LangFlo00/Projekt-RETI-Ladesaeule/Datenblätter/Einpoliger_Schaltplan.pptx

Ladesäule R-Bau L3E

3

Zuleitung HV

X0:1,2,3,N,PE

UMG604 I1-I3

40A/30mA
B

60A/5A

RCD

3

F100

F200

RCD

40A/30mA
B

F300

RCD

40A/30mA
A

UMG604 U1-U3

F1

B32

F2

B32

Z2

Z3

B13

SDM360

F4

Z1

SDM720

SDM720

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
-RPI
-EVSE

UMG604

Q1

EVSE

rel

A1

Q2

EVSE

rel

A1

X1:1,2,3,N,PE
CP,PP

X2:1,2,3,N,PE
CP,PP

K1

A2

K2

A2
