LangFlo00/Projekt-RETI-Ladesaeule/Projektvernissage/Projektvernissage_LaMa2_Pitch.pptx

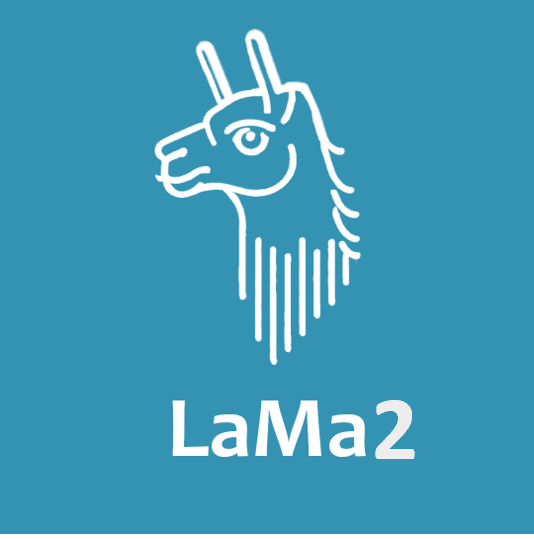
[picture p27: figure]

Projekt LadeManagement 2

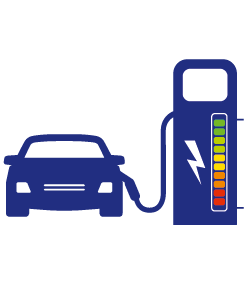
[picture p28: figure]
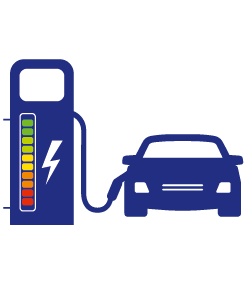
[picture p29: figure]
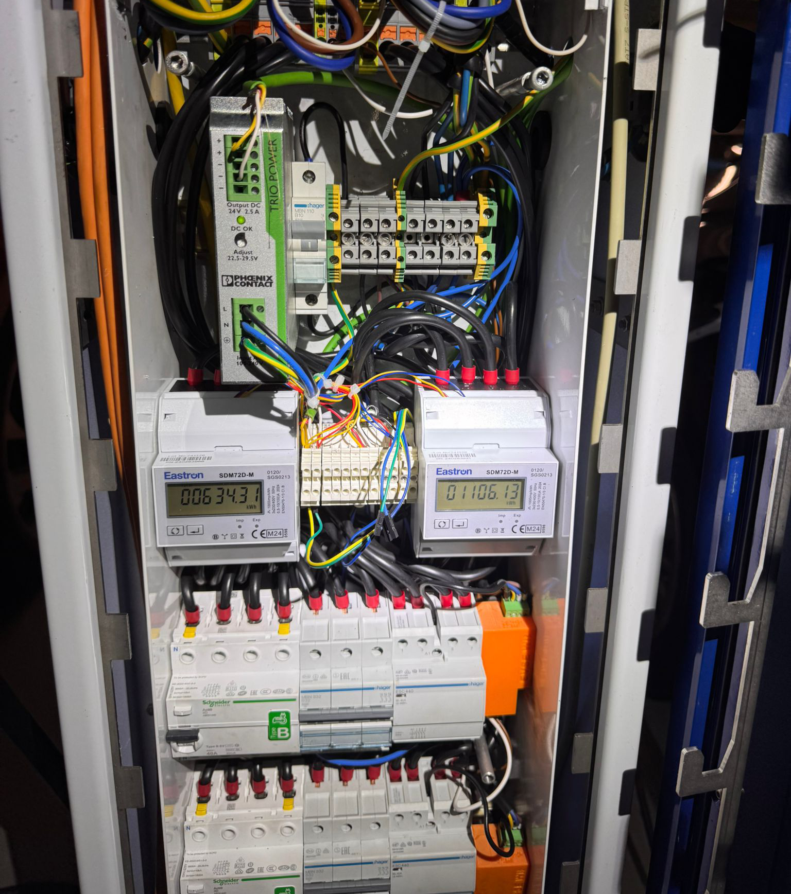
[picture p30: figure]
Hängebrücke über dem Wasser bei Sonnenuntergang

Was machen wir besser?
- Authentifizierung über Kartenleser mit den HM-Karten
- Optimierter Algorithmus für das Laden von mehreren E-Autos
- Anbinden von zusätzlichen Messgeräten
- Benachrichtigung wenn Auto vollständig geladen
