LangFlo00/Projekt-RETI-Ladesaeule/alte Dokus/LAMA-Doku/lama-doku-main/Sprint1.pptx

## Projekt Lademanagement

- Fuchs Joshua, Schulz Lukas, Häusler Alex

14.11.24

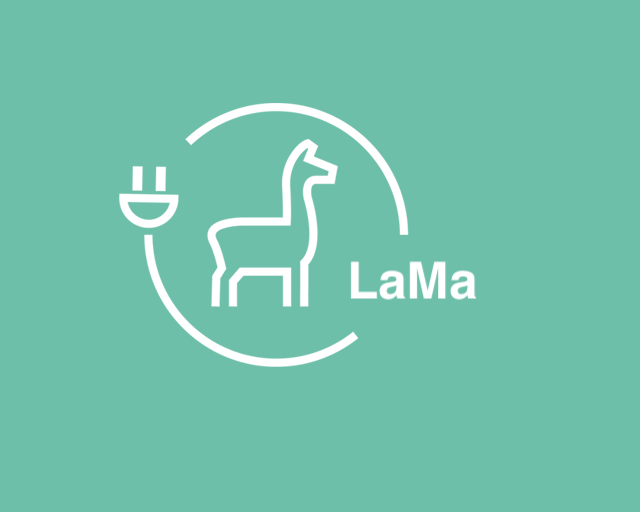
[picture p31: figure]
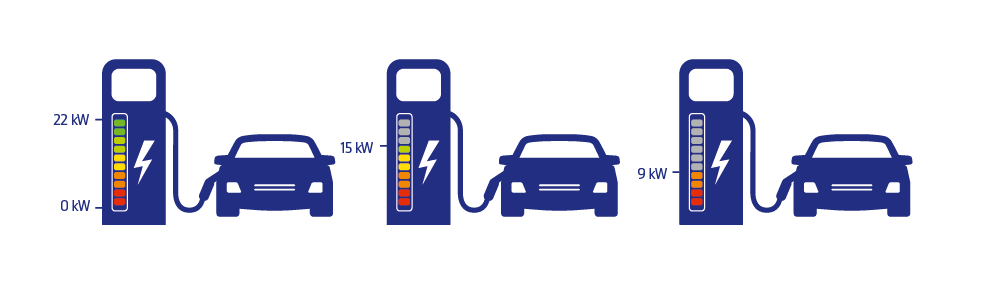
[picture p32: figure]

## Agenda-LAMA

1. Einführung in das Projekt und Zielsetzung
2. Simulationserläuterung und -präsentation
3. Übergabe an den Testaufbau
4. Demonstration der Datenkommunikation
5. Abschluss und Zusammenfassung

## 1. Einführung Projekt und Zielsetzung

Hängebrücke über dem Wasser bei Sonnenuntergang

Aktuell :
- Kein aktives Lademanagement
- Kein Datenabruf von Außen
Zielsetzung:
- Laderegler regelt aktiv für effizientes Laden
- Live-Daten Abruf und Fernsteuerung über Solarlabor

## Simulation

- Fuchs Joshua, Schulz Lukas, Häusler Alex

## Slide 5

Szenario 1 (keine Schuko-Last):
Szenario 2 (10A Schuko-Last auf Phase 1):

Auto 1 wird angehängt

3-phasig

3-phasig


Auto 2 wird angehängt

3-phasig

32A

16A

16A

Auto 1 wird angehängt

Auto 2 wird angehängt -> 2x 16A

3-phasig

3-phasig

1-phasig auf Phase 2

16A

32A

16A

## Slide 6

Szenario 3 (10A Schuko-Last auf Phase 1):

Auto 1 wird angehängt

1-phasig auf Phase 2

1-phasig auf Phase 2

Auto 2 wird angehängt

1-phasig auf Phase 1

32A

32A

16A

## 3. Übergabe an den Testaufbau

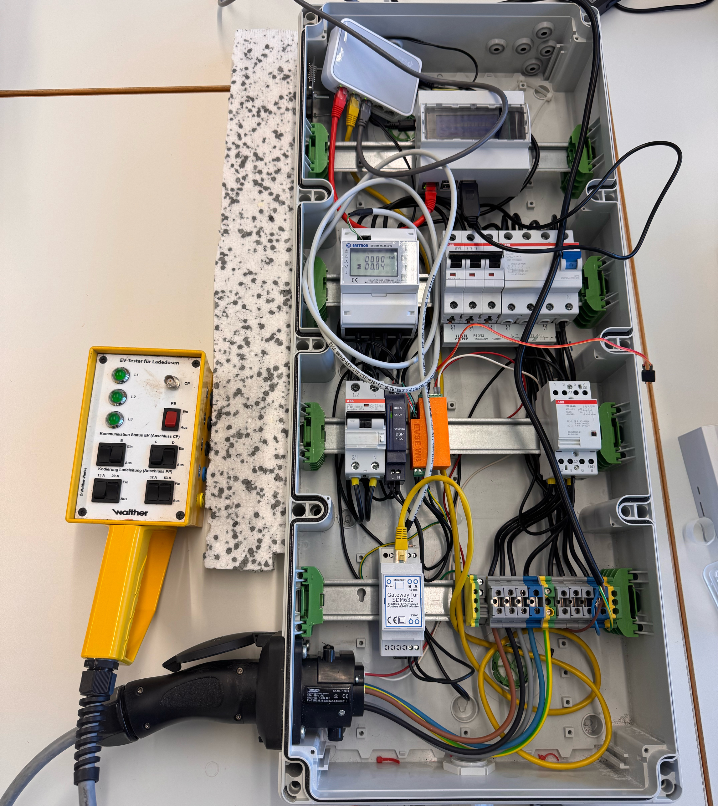
[picture p33: figure]
Hängebrücke über dem Wasser bei Sonnenuntergang

Raspberry Pi

Eastron Stromzähler

EVSE Laderegler

Schütz, schaltet nach EVSE
Kommunikation den
Strom frei für Typ 2

EV Tester für Typ 2

## 4. Demonstration der Datenkommunikation

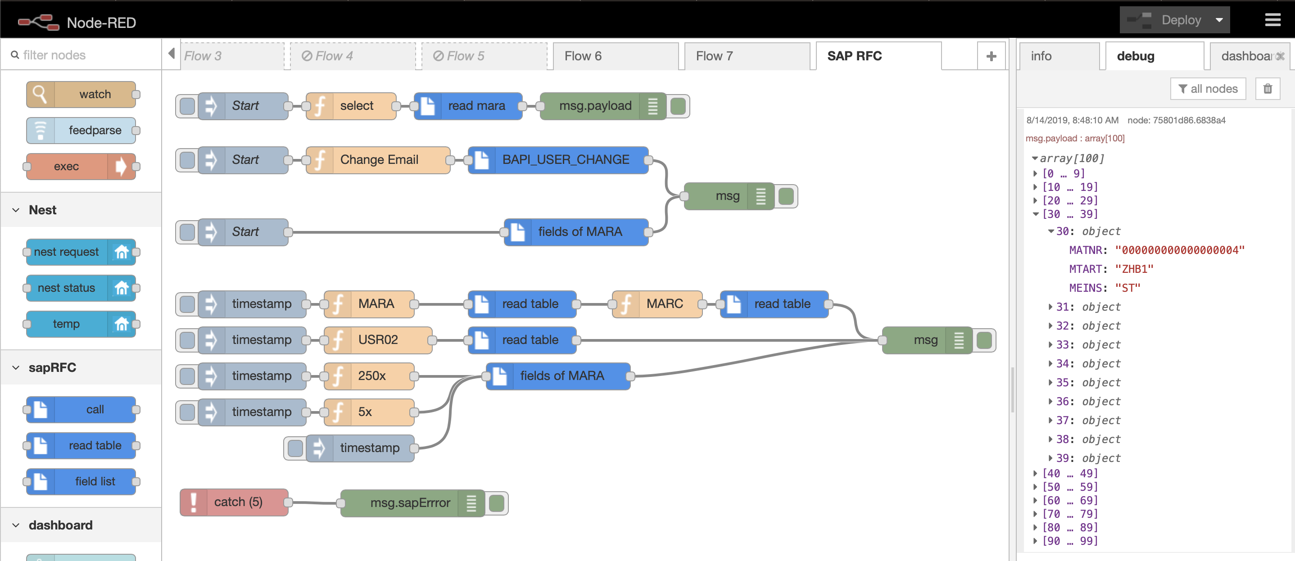
[picture p34: figure]
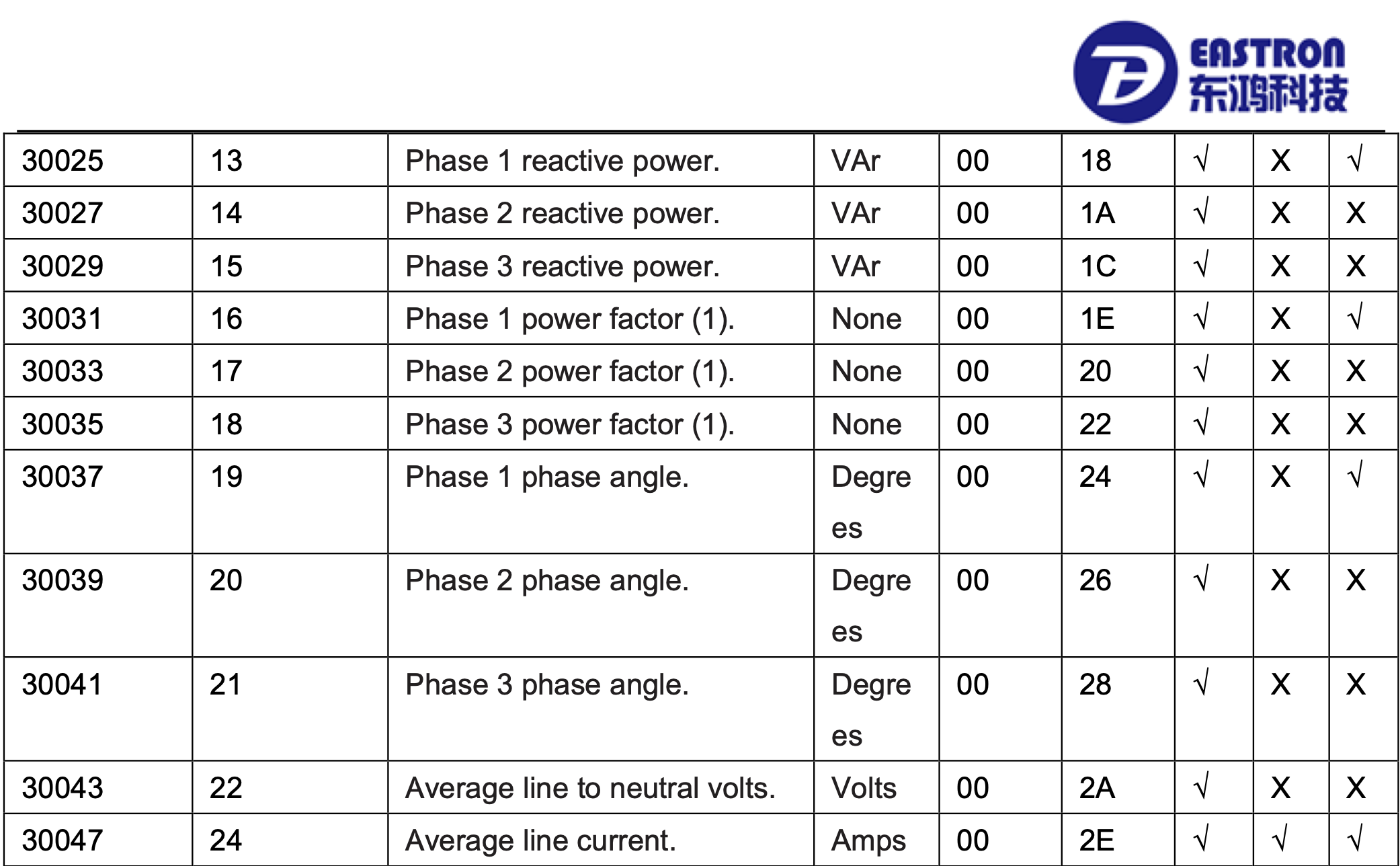
[picture p35: figure]

## 5. Abschluss und Zusammenfassung

Was Aktuell funktioniert:
- Der Raspberry Pi kann über Modbus mit dem Laderegler kommunizieren
- Node Red erkennt den Fahrzeugstatus (Verbunden, Lädt, Idee…)
Aufkommenden Ziele des Projektes:
- Messgeräte (Janitza und Eastron) über den Raspi auslesen über Node Red und Daten Verarbeiten
- Lade-Algorithmus erproben an beide Anschlüssen mit Testanschlüssen von bspw. Glühbirne / Heizlüfter
- Übertragen der Funktionalität auf Ladesäule in TG
- Datenempfang über Solarlabor implementieren, erproben
