LangFlo00/Projekt-RETI-Ladesaeule/Projektvernissage/Pitch_Folie.pptx

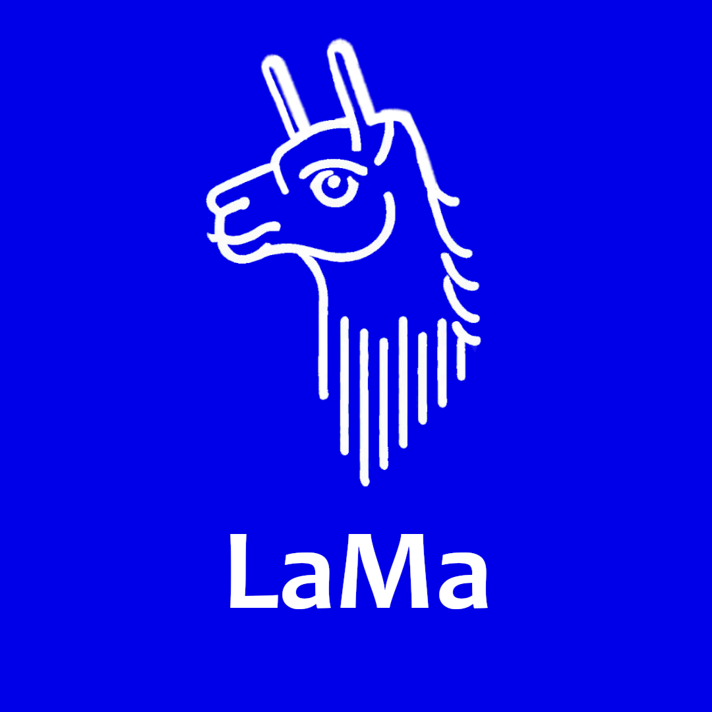
[picture p50: figure]

Projekt Lademanagement

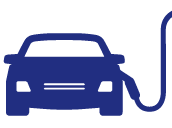
[picture p51: figure]
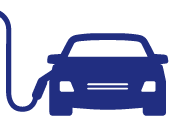
[picture p52: figure]

35 A Sicherung

Lösung: LaMa-Ladealgorithmus,
- Stromfluss dynamisch für die Autos einstellt & überwacht
- Sichert vor Überlast
- Reduziert Ladezeiten
