LangFlo00/Projekt-RETI-Ladesaeule/Sonstiges/Sprint/Sprint1.pptx

## LaMa

Toni Winkler, Florian Langlechner, Benedikt Schwendner, Anne Reddig Wiegand

## Slide 2

Agenda
1. Rückblick
2. Ladeoptimierung
3. Kartenleser TWN4 Multitech
4. Steuer-/Ladestromkreis
5. Benutzeranlegung und Freischalten
6. Sprint-Flow
7. Ausblick

## Slide 3

1. Rückblick

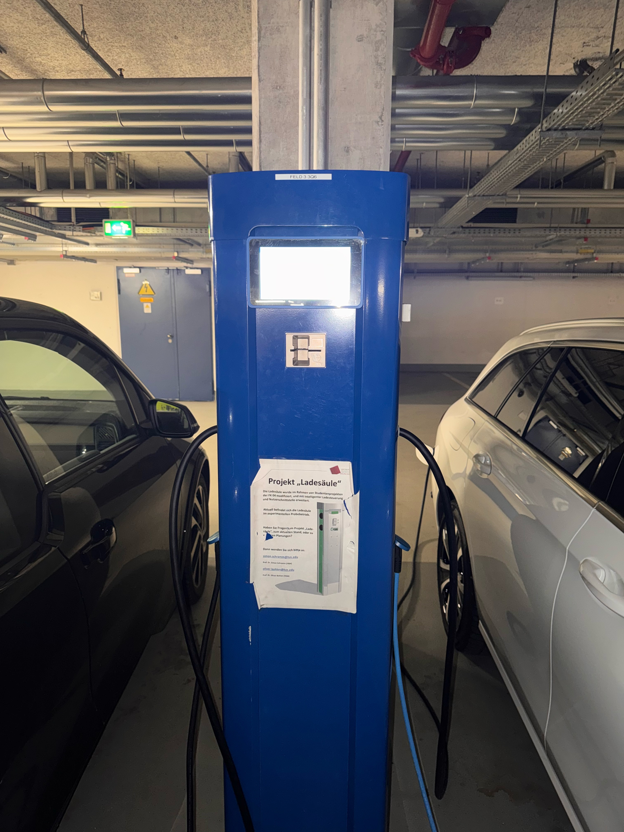
[picture p53: figure]

- Ladesäule gebaut von vorangegangenem Semester
- Ladesäule funktioniert
- hat kein Lademanagment
- wertet die Ladedaten nicht aus

## Slide 4

2. Ladeoptimierung

Stromzähler für CCS2 Stecker

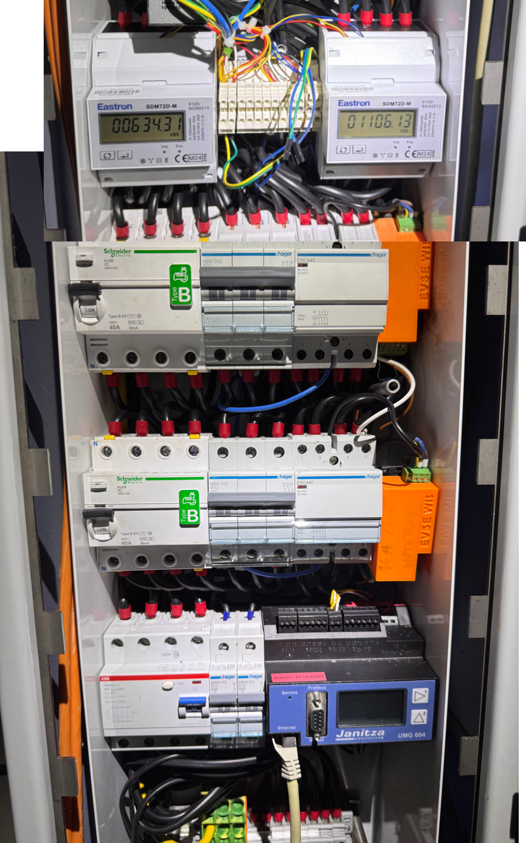
[picture p54: figure]

Ziel:
Eine Ladeoptimierung entwickeln
Vorgehen:
1. Durch die Stromzähler die Belastung der einzelnen Ladedosen messen
2. Entsprechend der angeschlossenen Fahrzeuge die Ladeleistung einstellen
(Durch Priorisierung und Trenddaten)

Stromzähler für gesamte Ladesäule

## 3. Kartenleser TWN4 Multitech

- Kommunikation über USB
- Verschiedene Möglichkeiten
  - HID: Konfiguration als Keyboard -> Schwierigkeiten in Node-Red
  - CDC: serielle Kommunikation

## Konfiguration in Node-Red

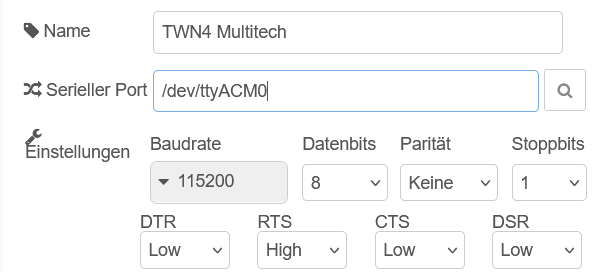
[picture p55: figure]

## 4. Steuer-/Ladestromkreis

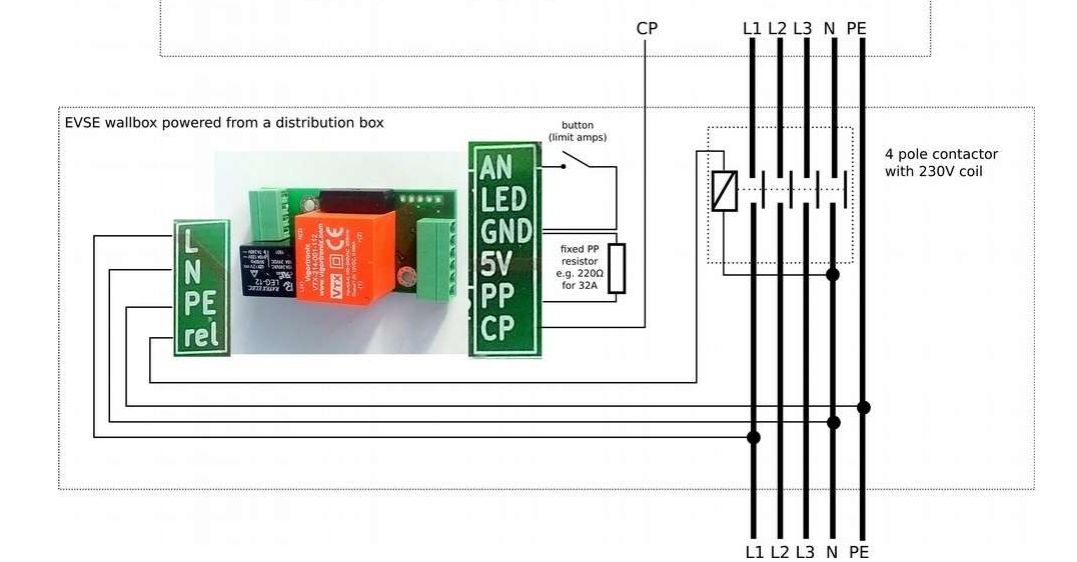
[picture p56: figure]
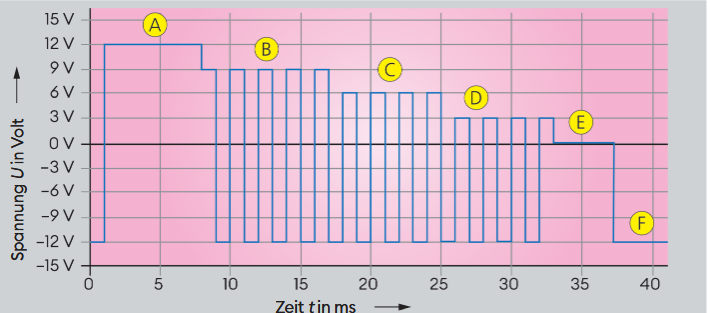
[picture p57: figure]

## Slide 8

5. Benutzeranlegung und Freischalten

Ziele:
Ladevorgang freischalten, Trenddaten erfassen und zuordnen

Personalisiertes Laden
→ Erfassen der Benutzer durch Kartenlesegerät

Speichern der Benutzer in einer Datenbank

Erfassen von den typischen Ladezeiten der einzelnen Benutzer

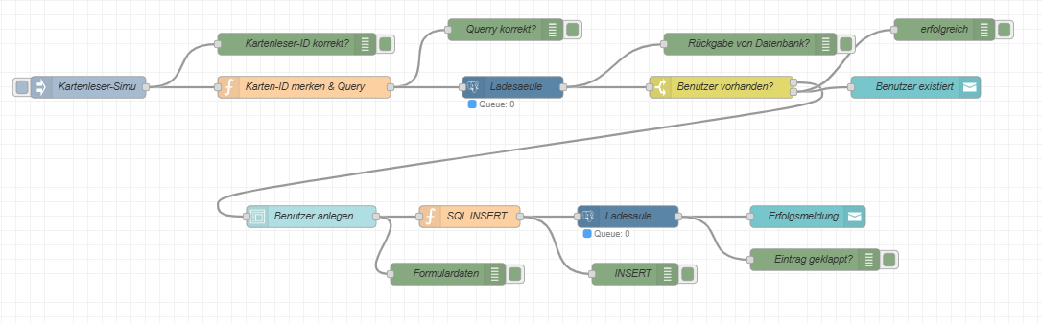
[picture p58: figure]

## 6. Sprint-Flow

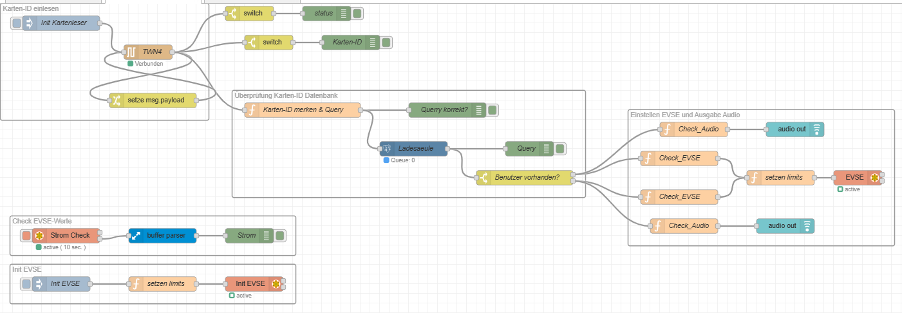
[picture p59: figure]
A diagram of a diagram

## 7. Ausblick

- Konfigurieren der Kartenleser-Firmware, z.B. Beep verändern, Format der ID
- Einbau der Authentifizierung in bestehenden LaMa-Flow
- Automatisch Anlegung von neuen Benutzern in der Datenbank
- Loggen der Ladevorgänge über PostgreSQL
- Stromzählerauswertung in Node-red
- Implementierung des Systems auf dem Raspberry
