LangFlo00/Projekt-RETI-Ladesaeule/Projektvernissage/LaMa2Poster.pdf

# Effizientes LadeManagement

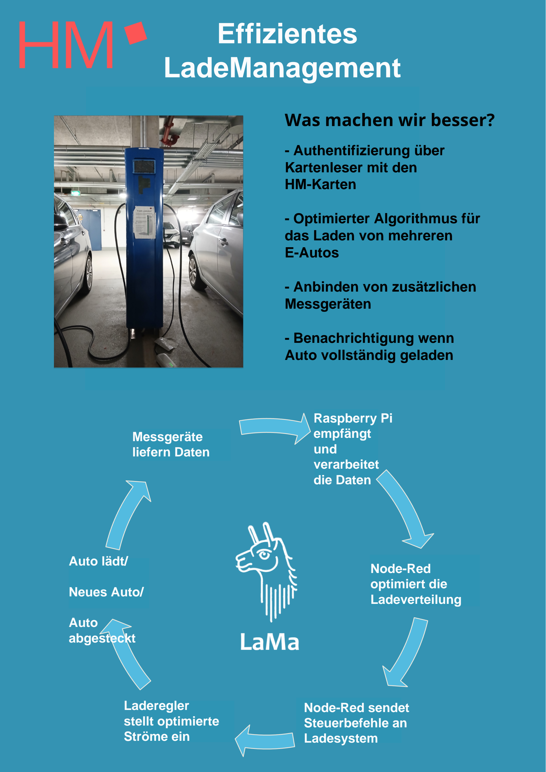
[picture p60: page 1]

### 35 A

Sicherung

Messgeräte
liefern Daten

Auto lädt/

Neues Auto/

Auto
abgesteckt

Laderegler
stellt optimierte
Ströme ein

Node-Red sendet
Steuerbefehle an
Ladesystem

Raspberry Pi
empfängt
und
verarbeitet
die Daten

Node-Red
optimiert die
Ladeverteilung
- Authentifizierung über
Kartenleser mit den
HM-Karten
- Optimierter Algorithmus für das Laden von mehreren
E-Autos
- Anbinden von zusätzlichen Messgeräten
- Benachrichtigung wenn
Auto vollständig geladen
