LangFlo00/Projekt-RETI-Ladesaeule/Projektvernissage/LaMaPoster.pdf

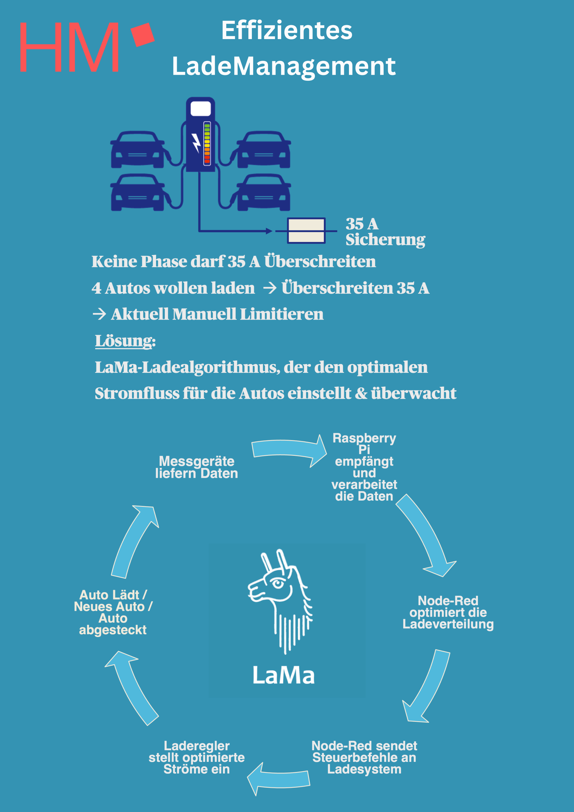
[picture p61: page 1]

Effizientes
LadeManagement
