LangFlo00/Projekt-RETI-Ladesaeule/3D-Druck/Screenshot_20250515-121134_Google.jpg

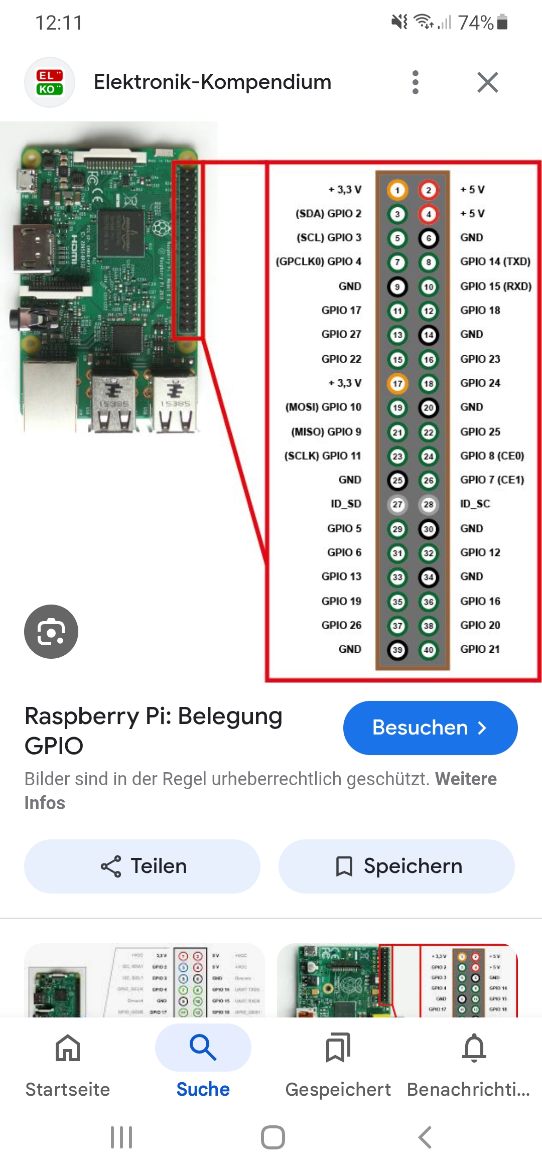
3D-Druck/Screenshot_20250515-121134_Google.jpg
