LangFlo00/Projekt-RETI-Ladesaeule/alte Dokus/LAMA-Doku/entwicklerdoku-main/images/evse_register_2.png

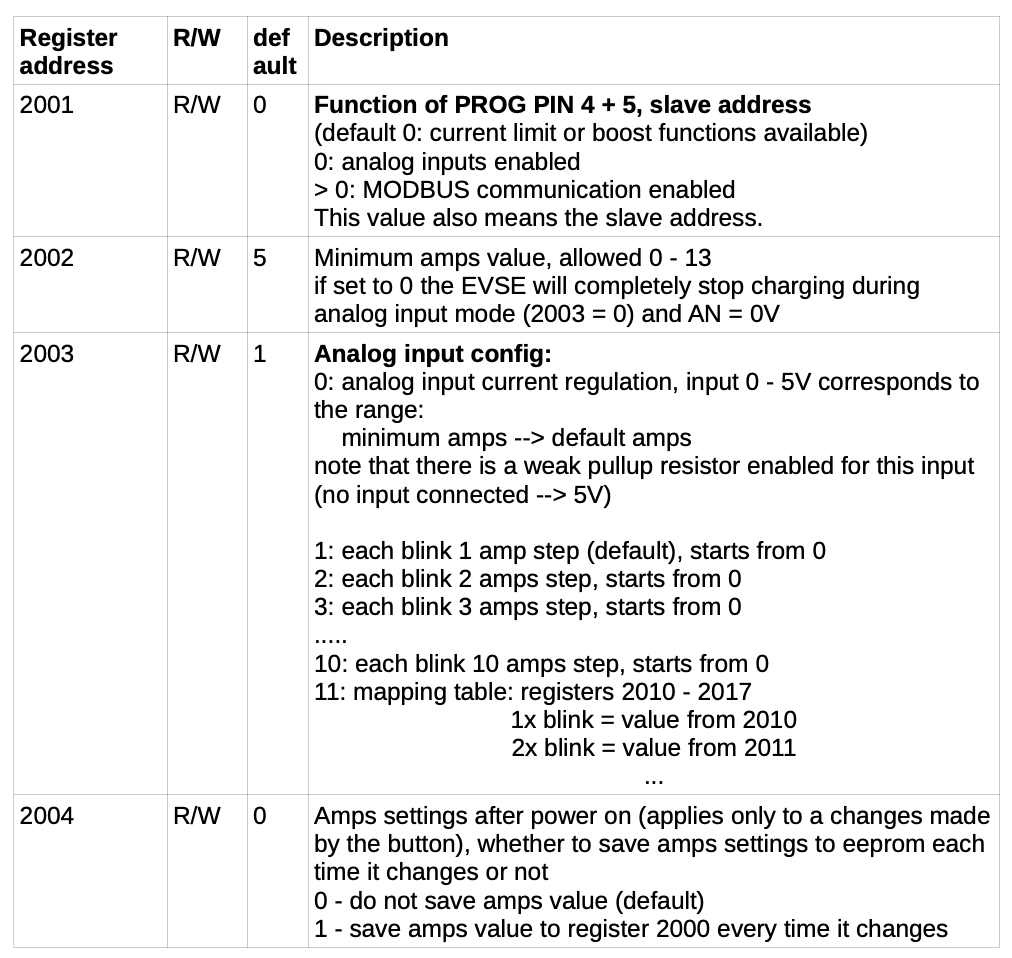
alte Dokus/LAMA-Doku/entwicklerdoku-main/images/evse_register_2.png
