LangFlo00/Projekt-RETI-Ladesaeule/alte Dokus/LAMA-Doku/entwicklerdoku-main/images/init.png

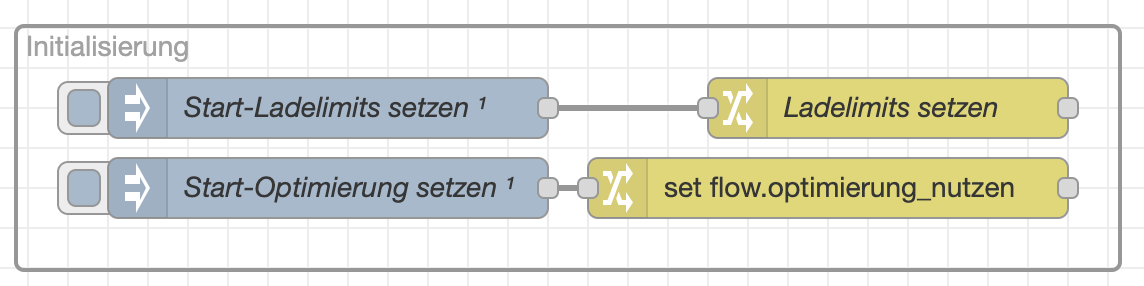
alte Dokus/LAMA-Doku/entwicklerdoku-main/images/init.png
