LangFlo00/Projekt-RETI-Ladesaeule/alte Dokus/LAMA-Doku/entwicklerdoku-main/images/reload_anzeigeseite.png

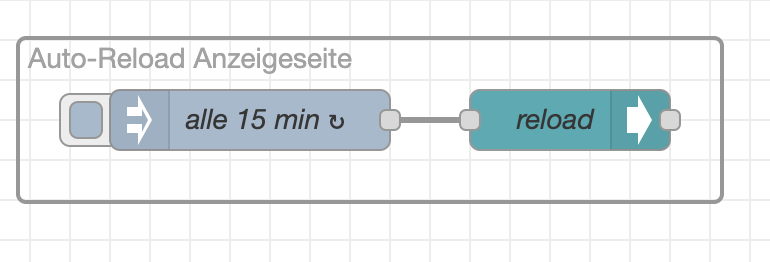
alte Dokus/LAMA-Doku/entwicklerdoku-main/images/reload_anzeigeseite.png
