LangFlo00/Projekt-RETI-Ladesaeule/alte Dokus/Projekt9_Ladesaeule/Projekt9_Ladesaeule/Materialliste.xls

Materialliste Vorprojekt
Lfd. Nr | Artikel | Anzahl | Einzelpreis Netto
1 | Raspberry Pi 3 Model B mit Gehäuse | 1 | 34.90 €
2 | Netzteil 12V MW HDR-30-12 | 1 | 15.35 €
3 | Netzteil 5V MW HDR-15_5 | 1 | 12.49 €
4 | ABB Stotz FI/LS Schalter 6kA DS201A-B16/0,03 | 1 | 27.83 €
5 | ABB Stotz FI-Schutzschalter pro M Compact F204A-40/0,03 | 1 | 26.98 €
6 | ABB Stotz Sicherungsautomat B, 6kA, 32A, 3P S203-B32 | 1 | 22.82 €
7 | ABB Stotz Installationsschütz 4S EBS 24-40 380V AC/DC | 1 | 28.67 €
8 | Mennekes Stecker Star TOP 32A, 5P, 6h, 400V, IP44 | 1 | 5.91 €
9 | PHOENIX C. 1409681 Ladesteckd. Typ 2 | 1 | 98.25 €
10 | PHOENIX C. Schutzdeckel EV-T2SC | 1 | 18.23 €
11 | PHOENIX C. AC-Ladesteuerung 3 Phasen, Mode 3 EM-CP-PP-ETH | 1 | 208.19 €
12 | H07RN-F 5x6mm² (in m) | 5 | 9.25 €
13 | H07V-K 6mm² (in m) | 100 | 29.40 €
14 | Kabelbinder | 10 | 1.00 €
15 | Gehäuse ca. 50x20x80cm | 1 | 110.00 €
16 | Aderendhülsen | 100 | 6.00 €
17 | SD-Karte Raspberry Pi | 1 | 6.95 €
18 | Erweiterungs-Platine Schwarz, Blau sbc-rfid-rc522 1503746-62 | 1 | 8.50 €
19 | Erweiterungs-Platine SBC-RFID-CLIP 1539582-62 | 1 | 4.80 €
Materialliste Erweiterung
 | PHOENIX Contact Verriegelung 1624129 Typ EV-T2M3S E-LOCK 12V | 1 | 44.61 €
 | TP-Link TL-SF1005D Netzwerk Switch (5x10/100MBit/s RJ45ports) | 1 | 8.32 €
Materialliste Emulator
 | Ladedose, Typ | 1 | 75.55 €
 | BIG 800001303 . Bobby - Car - Classic rot | 1 | 27.72 €
 | Drehschalter 250V/AC 5A Schaltpositionen 3 2x45° TRU COMPONENTS | 2 | 6.29 €
 | Meldeleuchte grün 230V BACO L20SC10H | 3 | 5.98 €
 | Hutschiene ungelocht Stahlblech 106mm Fibox Euronord | 1 | 1.27 €
 | Europlatine Hartpapier 90 mm x 50 mm 35 µm Rastermaß 5.08 mm | 1 | 1.15 €
 | verschiedene Widerstände, Lötzinn, Lötstifte | 1 | 0.84 €
 | Kleinstmaterial, Schrauben, Abstände, Scharniere, Flügelmutter | 1 | 7.98 €
