LangFlo00/Projekt-RETI-Ladesaeule/3D-Druck/Bildschirmhalterung/Bilschirm-Rahmen_v4.stl

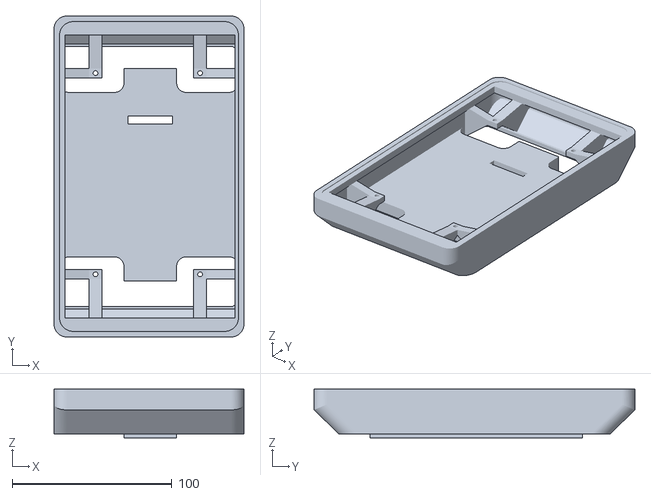
[picture p70: CAD file, 2026-10-05]
3D-Druck/Bildschirmhalterung/Bilschirm-Rahmen_v4.stl
119.0 x 201.0 x 30.5
