LangFlo00/Projekt-RETI-Ladesaeule/3D-Druck/Leserhalter_3D-Druck_v7.3mf

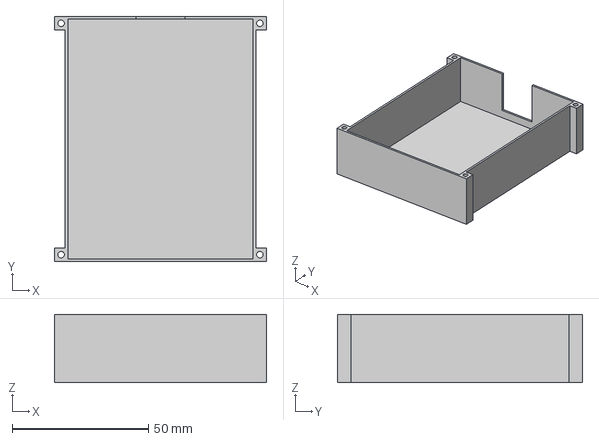
[picture p71: CAD file, 2026-10-05]
3D-Druck/Leserhalter_3D-Druck_v7.3mf
78.0 x 90.0 x 25.0 mm
