LangFlo00/Projekt-RETI-Ladesaeule/3D-Druck/Bildschirmhalterung/Pi-Halterung_v4.stl

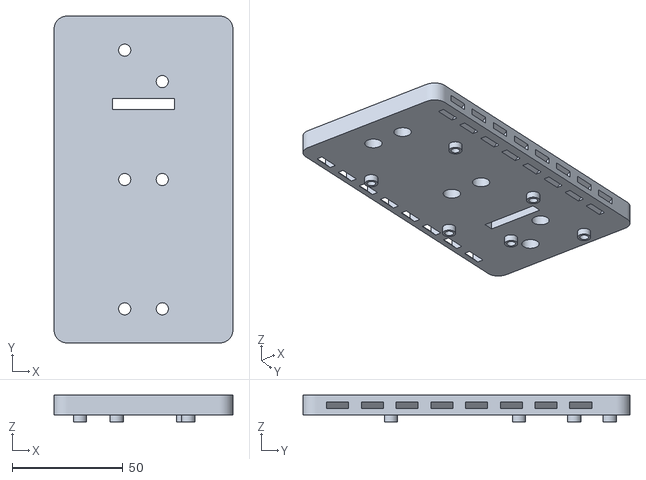
[picture p72: CAD file, 2026-10-05]
3D-Druck/Bildschirmhalterung/Pi-Halterung_v4.stl
81.0 x 147.9 x 12.0
