LangFlo00/Projekt-RETI-Ladesaeule/(list of files, cad)

Other CAD files:
3D-Druck/Bildschirmhalterung/Pi-Halterung.f3d
3D-Druck/Leserhalter v7.f3d
alte Dokus/LAMA-Doku/lama-doku-main/Bildschirmhalterung/Pi-Halterung.f3d
