LangFlo00/Projekt-RETI-Ladesaeule/alte Dokus/LAMA-Doku/LaMa_Anwendermanual.docx

Projekt Lademanagement

Ziel: Effizientes Ladesystem
Anforderungen: Keine Phase darf 32 A überschreiten

1.Ladesäule Aufbau (außen)

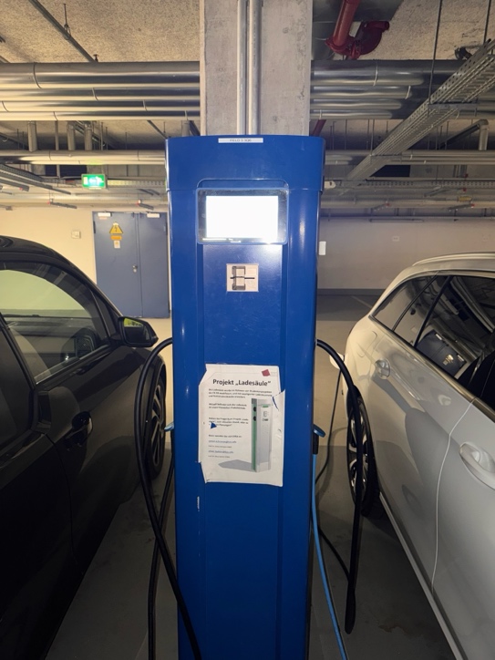
[picture p77: figure]

Pi + Display

Schuko-

Anschlüsse

Typ 2 Stecker

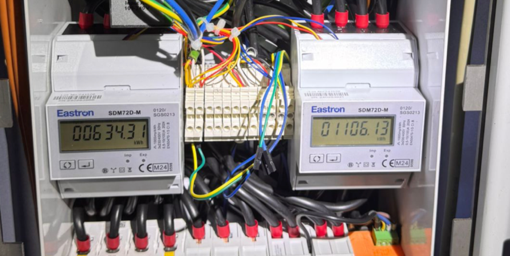
[picture p78: figure]
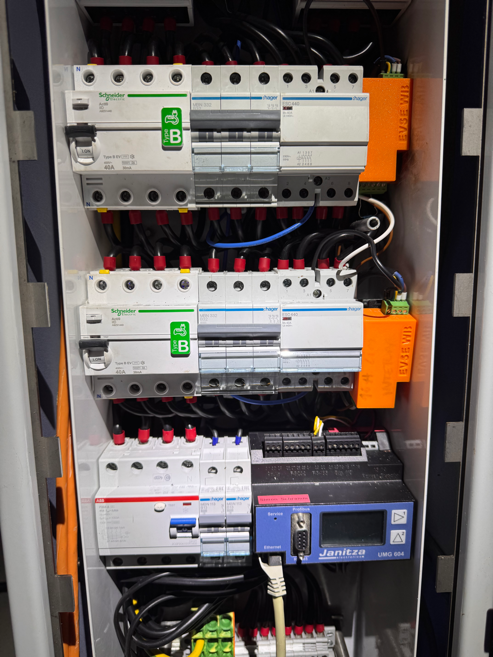
[picture p79: figure]

2. Hardwarekomponenten (innen)

Stromzähler (Eastron)

Strommessgerät (Janitza)

EVSE Laderegler

EVSE Laderegler

1. EVSE-Laderegler:

- verbindet sich über Modbus RTU mit dem Pi und den angeschlossenen Autos
- Gibt unsere errechneten Stromlimits vor

2. Strommessung (Janitza, Eastron):

- Über Modbus TCP mit dem Pi verbunden
- Erfassen den Stromverbrauch auf den Phasen und

Leiten die Daten an den Pi weiter

3. Softwarekomponenten:

- Node-Red läuft auf dem Pi
- Empfängt Daten von EVSE und Messgeräten
- Node-Red erstellt Steuerbefehle und sendet sie an EVSE
- Node-Red erstellt das grafische Interface das auf dem Display vor Ort angezeigt wird

Node-Red wurde als

Grafische Entwicklungsumgebung genutzt damit der Algorithmus leichter zu bauen ist.

(Lego Prinzip)

Für die Verwendung von Node Red auf dem PI der Ladesäule, wurde zunächst das Programm Docker installiert damit jeder Student erstmal lokal auf den Laptops den Algorithmus testen kann, bevor er auf dem Pi der Säule implementiert wird.

Docker erstellt containerisierte Umgebungen, die unabhängig vom Host-System laufen. Das bedeutet, dass Änderungen, Fehler oder Abstürze in der Node-RED-Instanz nicht das Betriebssystem deines Laptops oder des Raspberry Pi beeinträchtigen.

Öffne dein Terminal oder deine Kommandozeile und gib den folgenden Befehl ein, um das Node-RED-Image herunterzuladen: docker pull nodered/node-red

Schritt 1: Starte einen Node-RED-Container

Führe diesen Befehl aus, um Node-RED in einem Container zu starten:

docker run -d -p 1880:1880 --name mynodered nodered/node-red

- -d: Startet den Container im Hintergrund.
- -p 1880:1880: Leitet den Port 1880 des Containers auf deinen Host-PC weiter (Node-RED ist dann im Browser unter http://localhost:1880 erreichbar).
- --name mynodered: Gibt deinem Container den Namen „mynodered“, damit du ihn leicht identifizieren kannst.
- nodered/node-red: Das Image, das verwendet wird.

Schritt 2: Teste Node-RED

Öffne deinen Browser und navigiere zu: http://localhost:1880

Du solltest die Node-RED-Oberfläche sehen. Du kannst jetzt Flows erstellen und testen.

Danach musst du je nach gewünschten Blöcken noch Über den Reiter Paletten ein paar Bibliotheken Installieren.

An Anfang des Projekts haben wir erstmal alle Ladefälle aufgeschrieben die Vorkommen könnten.

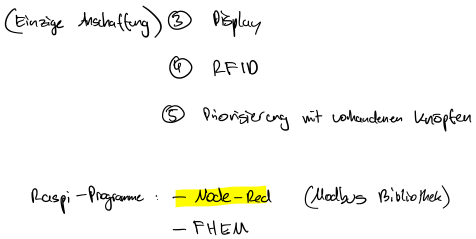
[picture p80: figure]
Freihandzeichnungen Freihandzeichnungen Freihandzeichnungen Freihandzeichnungen Freihandzeichnungen Freihandzeichnungen Freihandzeichnungen Freihandzeichnungen Freihandzeichnungen Freihandzeichnungen Freihandzeichnungen Freihandzeichnungen Freihandzeichnungen Freihandzeichnungen Freihandzeichnunge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
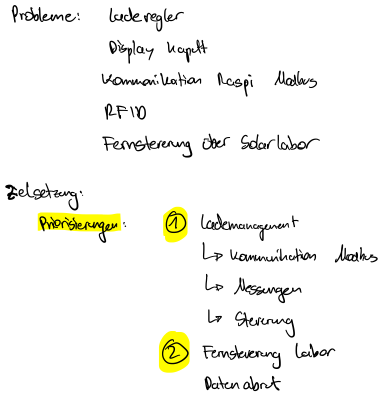
[picture p81: figure]
Freihandzeichnungen Freihandzeichnungen Freihandzeichnungen Freihandzeichnungen Freihandzeichnungen Freihandzeichnungen Freihandzeichnungen Freihandzeichnungen Freihandzeichnungen Freihandzeichnungen Freihandzeichnungen Freihandzeichnungen Freihandzeichnungen Freihandzeichnungen Freihandzeichnunge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
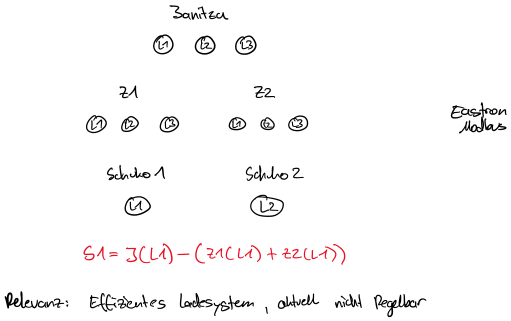
[picture p82: figure]
Freihandzeichnungen Freihandzeichnungen Freihandzeichnungen Freihandzeichnungen Freihandzeichnungen Freihandzeichnungen Freihandzeichnungen Freihandzeichnungen Freihandzeichnungen Freihandzeichnungen Freihandzeichnungen Freihandzeichnungen Freihandzeichnungen Freihandzeichnungen Freihandzeichnunge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

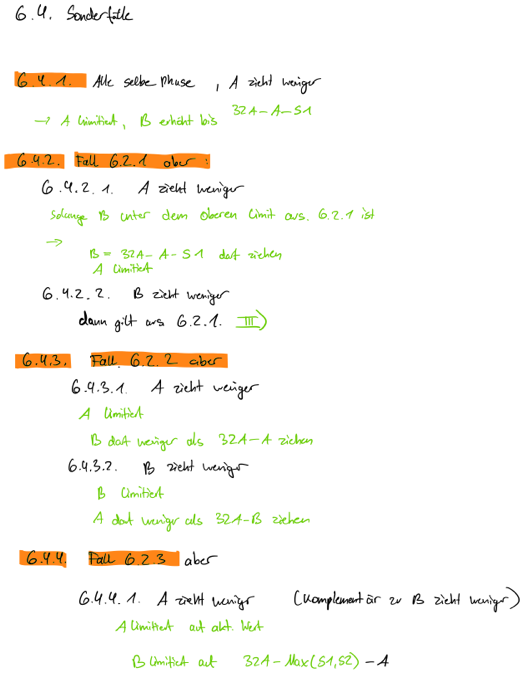
[picture p83: figure]
Freihandzeichnungen Freihandzeichnungen Freihandzeichnungen Freihandzeichnungen Freihandzeichnungen Freihandzeichnungen Freihandzeichnungen Freihandzeichnungen Freihandzeichnungen Freihandzeichnungen Freihandzeichnungen Freihandzeichnungen Freihandzeichnungen Freihandzeichnungen Freihandzeichnunge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
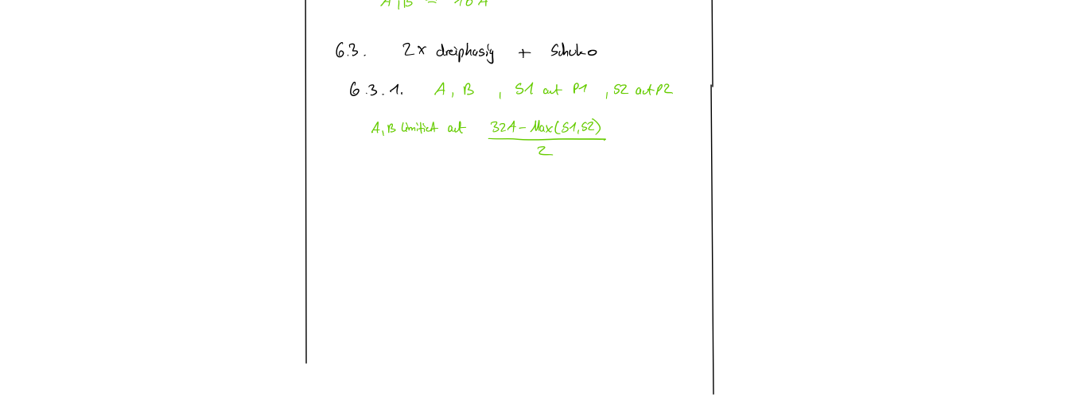
[picture p84: figure]
Freihandzeichnungen Freihandzeichnungen Freihandzeichnungen Freihandzeichnungen Freihandzeichnungen Freihandzeichnungen Freihandzeichnungen Freihandzeichnungen Freihandzeichnungen Freihandzeichnungen Freihandzeichnungen Freihandzeichnungen Freihandzeichnungen Freihandzeichnungen Freihandzeichnunge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
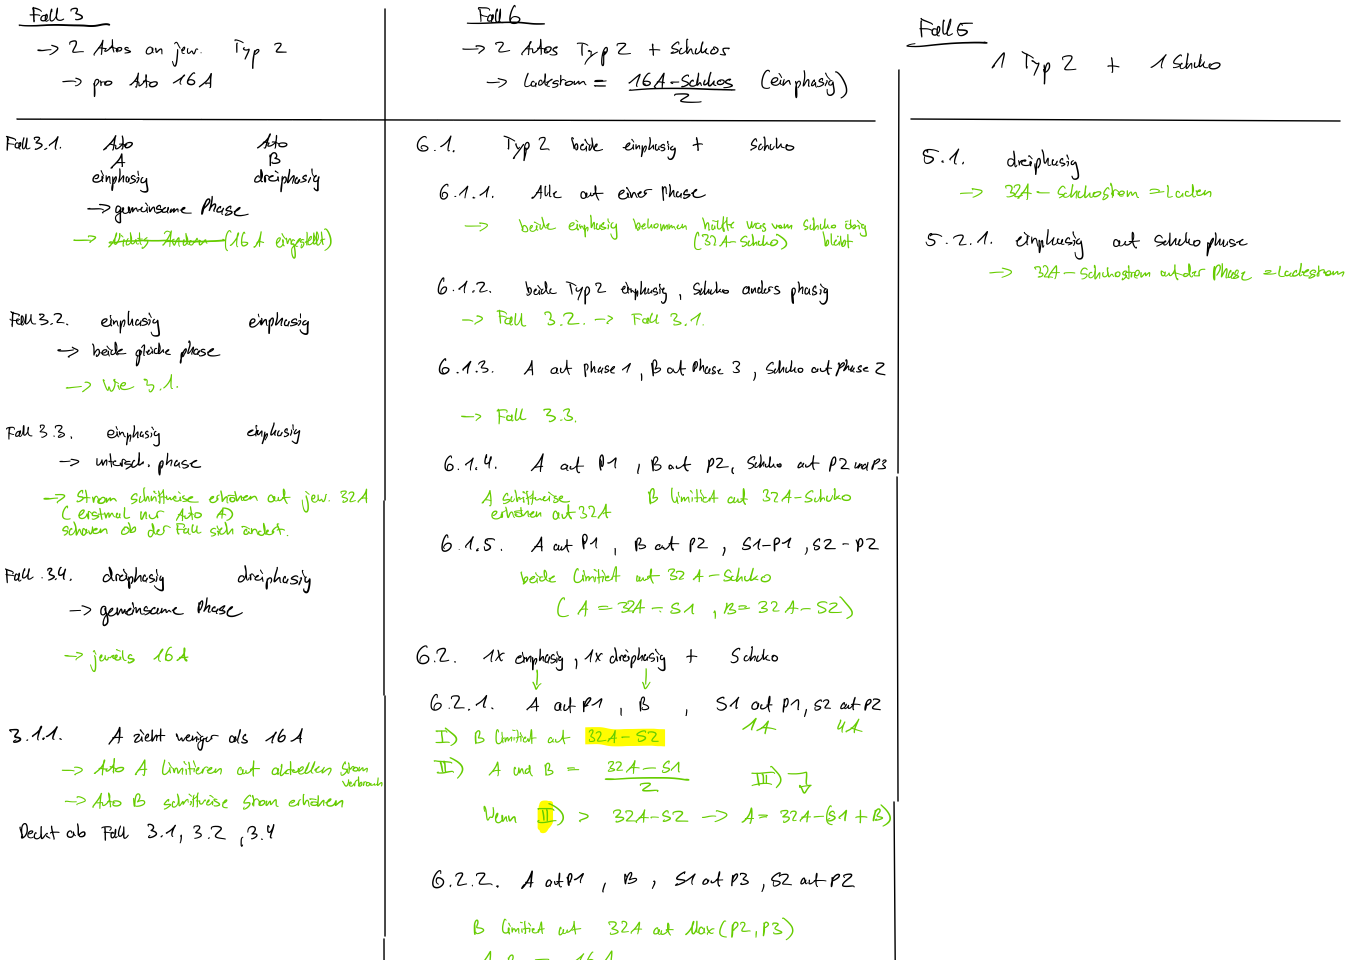
[picture p85: figure]
Freihandzeichnungen Freihandzeichnungen Freihandzeichnungen Freihandzeichnungen Freihandzeichnungen Freihandzeichnungen Freihandzeichnungen Freihandzeichnungen Freihandzeichnungen Freihandzeichnungen Freihandzeichnungen Freihandzeichnungen Freihandzeichnungen Freihandzeichnungen Freihandzeichnunge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

(Info: bis kurz vor Ende des Projektes war uns gesagt worden, dass keine Phase 32 A überschreiten darf und dann am Schluss erst 35 A, deshalb haben wir im Folgenden immer mit 32 A als Limit gerechnet) (Zum Nachlesen auf Git nochmal hochgeladen)

4. Optionaler Zubau eines RFID Card Reader

In diesem Projekt wurde versucht einen Kartenleser in die Ladesäule zu implementieren, jedoch war es noch nicht möglich die normalen Benutzerkarten die jeder Besitzt auszulesen.

Aktuelle Recherchen haben ergeben das es sich beiden Karten um sogenannte Legic Avant Karten handeln könnte. Es sind aber auch Prime Karten im Umlauf. Für Prime Karten braucht man einen speziellen Legic Leser, weil die einen eigenen Übertragungsstandard implementiert haben. (ISO 14443) Mit normalen RFID-Readern ist es nicht möglich diese Karten auszulesen, deshalb müsste ein Legic Reader besorgt werden. (ungefähr ab 80 €)

Software zum Leser der Karten könnten sein: CTC4096-MM410, MIM256-MN/MIM1024-MN

Zusätzlich müsste noch der Node Red Algorithmus angepasst werden, es war mal gewünscht das wir Priorisiertes Laden ermöglichen sollen damit.

5. Grafische Oberflächen

5.1 Oberfläche Entwickler

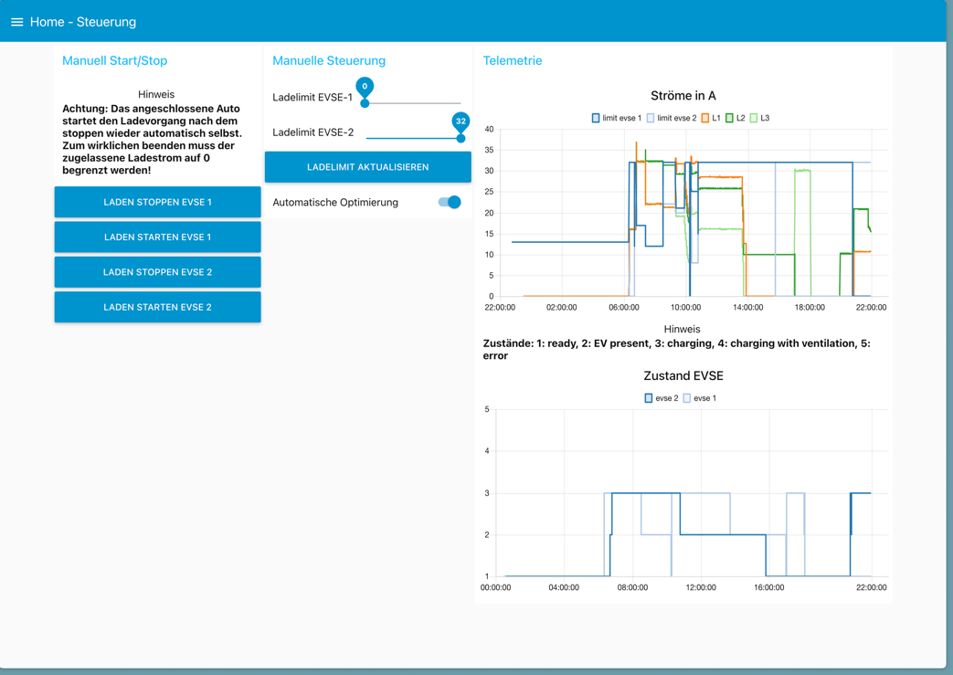
[picture p86: figure]

Hier in diesem Bild sieht man die Oberfläche der Steuerung, das ist nicht die Oberfläche, die jemand an der Ladesäule sieht, sondern die der Entwickler.

Damit der Ladealgorithmus auch manuell gesteuert werden kann befinden sich im Bild unter „Manuelle Steuerung“ zwei Schieber, welche den Strom der Anschlüsse limitieren.

Unter der Grafik „Zustand EVSE“ versteht man die Ladezustände der Autos, denn beim Anschluss eines Autos bekommt der EVSE über Modbus die Info in welchem Zustand sich das Auto befindet. Sollte man sich nun wundern, nach dem Anschluss seines Autos, warum es nicht lädt, könnte man über die Zustand EVSE-Grafik die Info bekommen ob es sich evtl. in einem Fehlerzustand befindet.

5.2 Oberfläche Benutzer

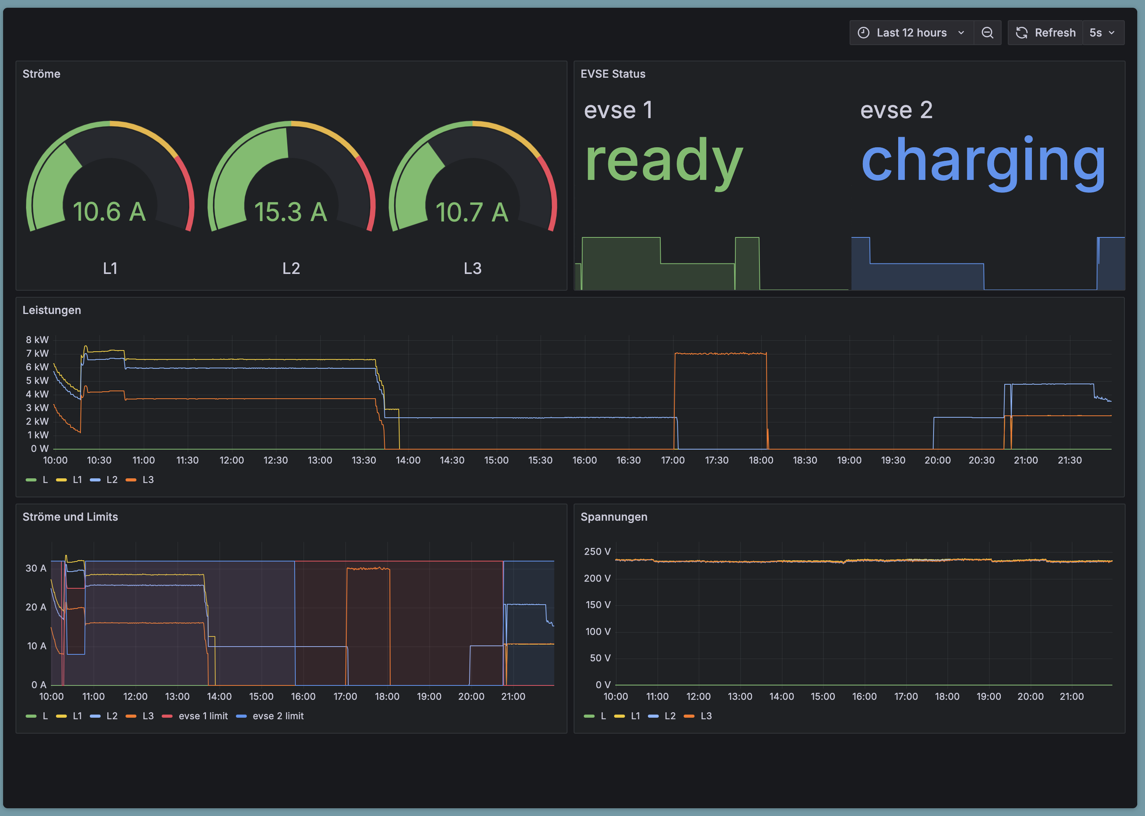
[picture p87: figure]

Oben Links sind die Ströme der Phasen L1, L2, L3 zu erkennen. Rechts daneben sieht man „EVSE1 ready“ was den Zustand des TYP2 Anschluss beschreibt, denn das heißt das kein Auto angeschlossen ist. Im Gegensatz dazu ist der zweite TYP2 Anschluss gelegt und lädt gerade ein Auto (EVSE2 charging).

Darunter ist die gesamte verbrauchte Leistung der Säule, aufgeteilt auf die Phasen visualisiert.

Zuletzt noch die Ströme und Spannungen der Phasen damit man sich auch die Leistung erklären kann und zusätzlich sieht, wann der Algorithmus die Ladelimits gesetzt hat bzw. wieder aufgelöst hat.
