LangFlo00/Projekt-RETI-Ladesaeule/Datenblätter/Ladesäule Verdrahtungsplan.pdf

# Hinweis:

## Hier ist nur die Verdrahtung von

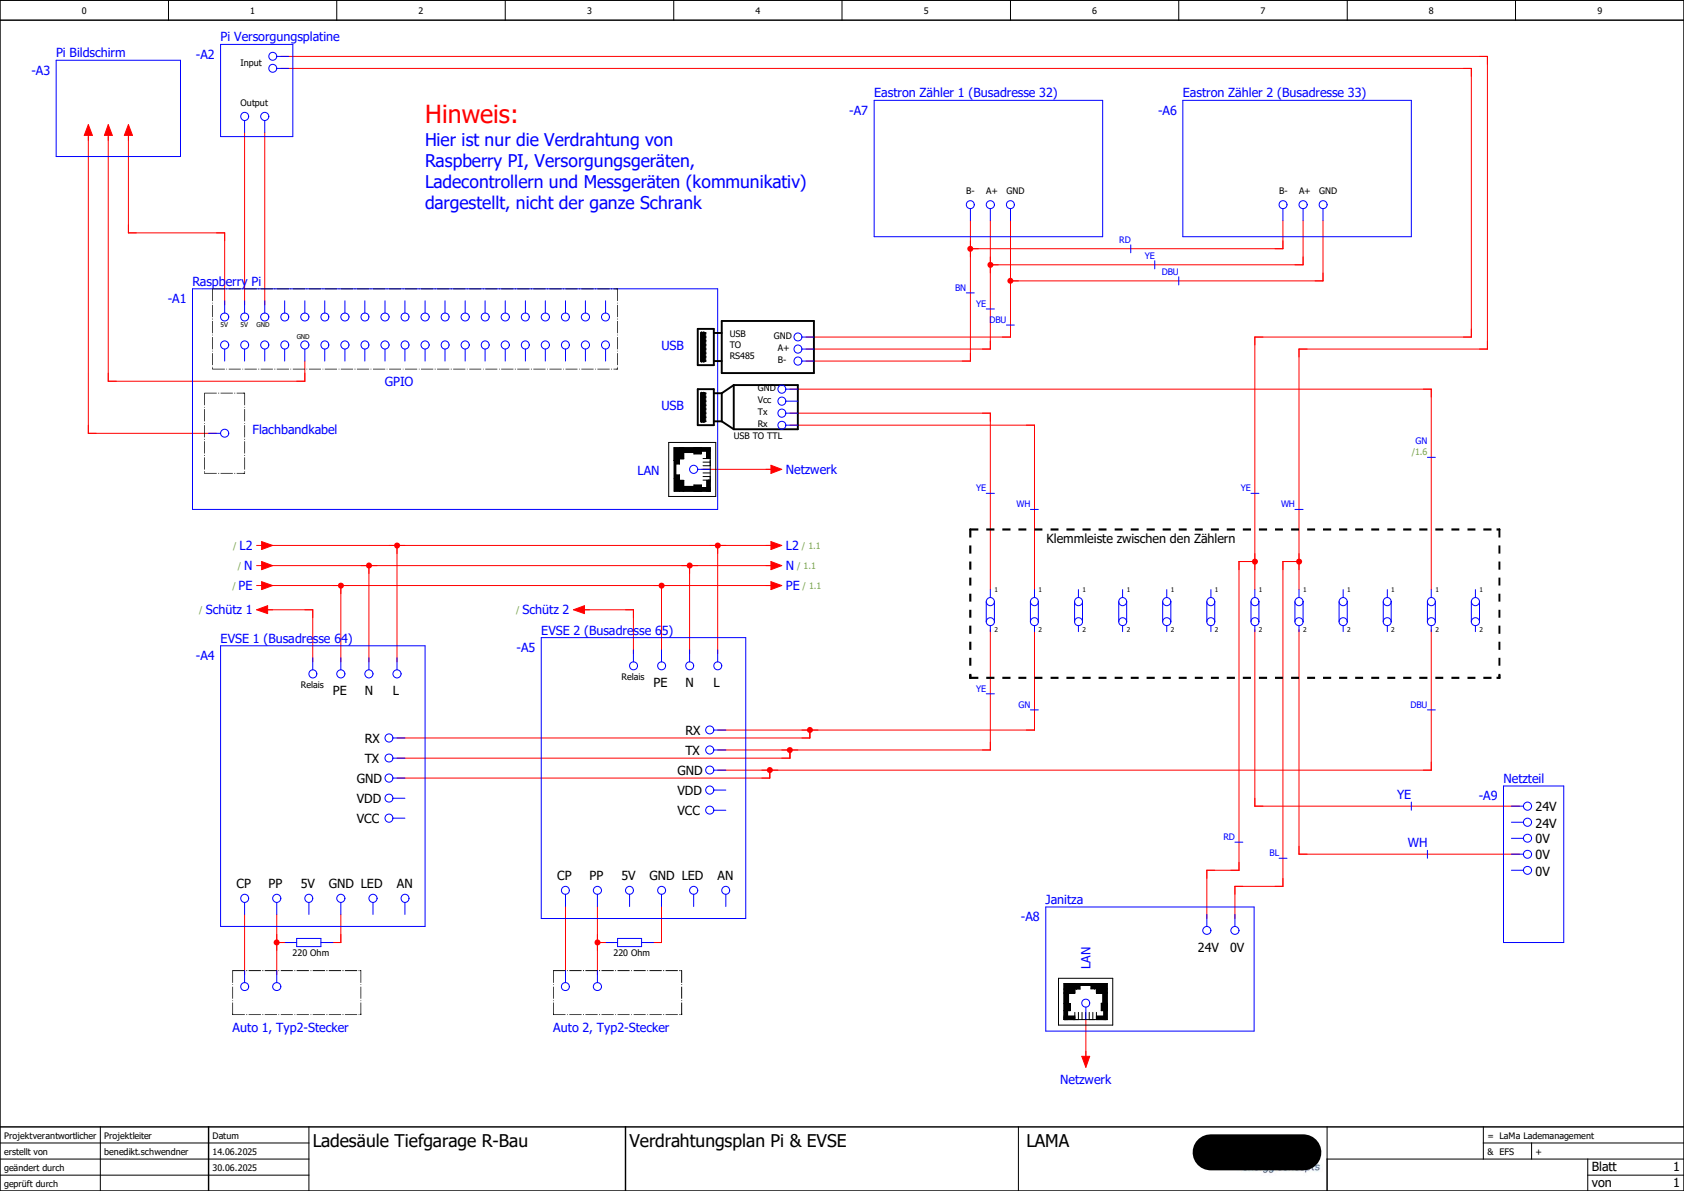
[picture p88: page 1]
Blatt; Datum; LaMa Lademanagement; EFS; geprüft durch; LAMA; Projektverantwortlicher; Projektleiter; von; Pi Versorgungsplatine; Raspberry Pi; 5V GND; GND; Flachbandkabel; GPIO; Pi Bildschirm; USB; A+ GND; EVSE 1 (Busadresse 64); 5V GND LED AN; RX TX GND VDD VCC; Relais PE; Janitza; 24V 0V LAN; GND Vcc Tx Rx; USB TO RS485; Netzteil; Output; Input; EVSE 2 (Busadresse 65); Relais PE N; Auto 1, Typ2-Stecker; Auto 2, Typ2-Stecker; 220 Ohm; LAN; USB TO TTL; DBU; Netzwerk; / Schütz 1; / Schütz 2

Eastron Zähler 1 (Busadresse 32)

Eastron Zähler 2 (Busadresse 33)

Raspberry PI, Versorgungsgeräten,
Ladecontrollern und Messgeräten (kommunikativ)
dargestellt, nicht der ganze Schrank

Klemmleiste zwischen den Zählern

TX
GND

VDD VCC CP PP 5V GND LED AN

Ladesäule Tiefgarage R-Bau

Verdrahtungsplan Pi & EVSE

erstellt von | benedikt.schwendner | 14.06.2025
geändert durch | | 30.06.2025
