LangFlo00/Projekt-RETI-Ladesaeule/alte Dokus/LAMA-Doku/lama-doku-main/LaMa_Verdrahtungsplan_Pi_EVSE.pdf

# Hinweis:

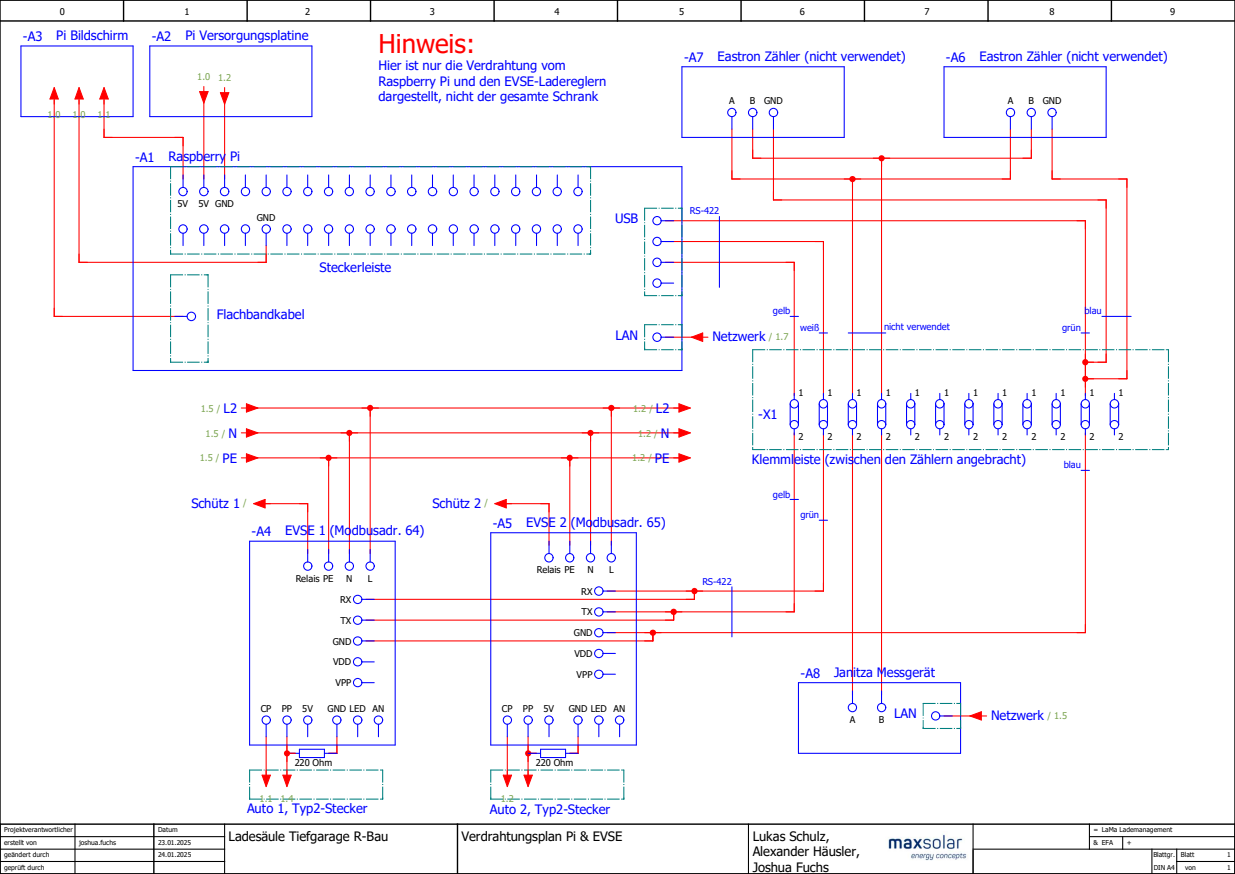
[picture p89: page 1]
Projektverantwortlicher; = Verdrahtungsplan Pi & EVSE erstellt von; von; -A1 Raspberry Pi; 5V 5V GND; GND; USB; LAN; Steckerleiste; Flachbandkabel; -A3 Pi Bildschirm; -A2 Pi Versorgungsplatine; -A4 EVSE 1 (Modbusadr. 64); Relais PE N; VDD; VPP; GND LED AN; -A7 Eastron Zähler (nicht verwendet); -A6 Eastron Zähler (nicht verwendet); -A5 EVSE 2 (Modbusadr. 65); weiß; gelb; grün; blau; Auto 1, Typ2-Stecker; Auto 2, Typ2-Stecker; 220 Ohm; -A8 Janitza Messgerät; LAN A; B GND; nicht verwendet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

Hier ist nur die Verdrahtung vom
Raspberry Pi und den EVSE-Ladereglern
dargestellt, nicht der gesamte Schrank

Klemmleiste (zwischen den Zählern angebracht)

GND

VDD VPP CP PP 5V GND LED AN

Datum | Ladesäule Tiefgarage R-Bau | Lukas Schulz, Alexander Häusler, Joshua Fuchs | LaMa Lademanagement
geprüft durch geändert durch | joshua.fuchs | 23.01.2025 | | | & EFA | +

24.01.2025 | | | Blattgr. DIN A4 | Blatt 1
