LangFlo00/Projekt-RETI-Ladesaeule/3D-Druck/Anschlüsse_Raspi.jpg

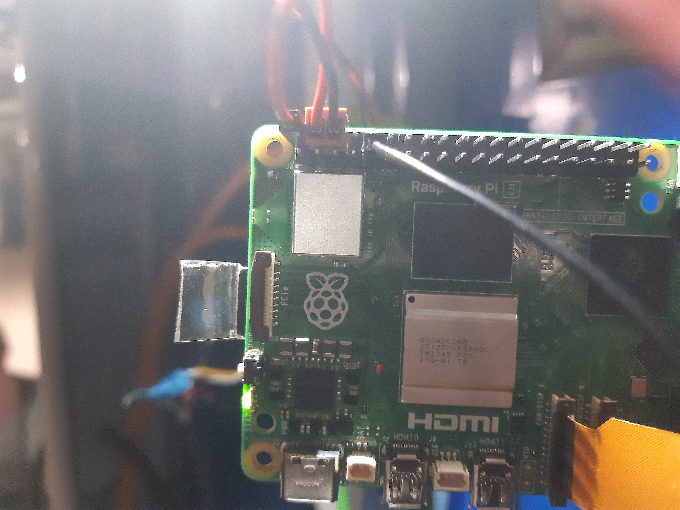
3D-Druck/Anschlüsse_Raspi.jpg
