LangFlo00/Projekt-RETI-Ladesaeule/3D-Druck/Bildschirm hinten.jpg

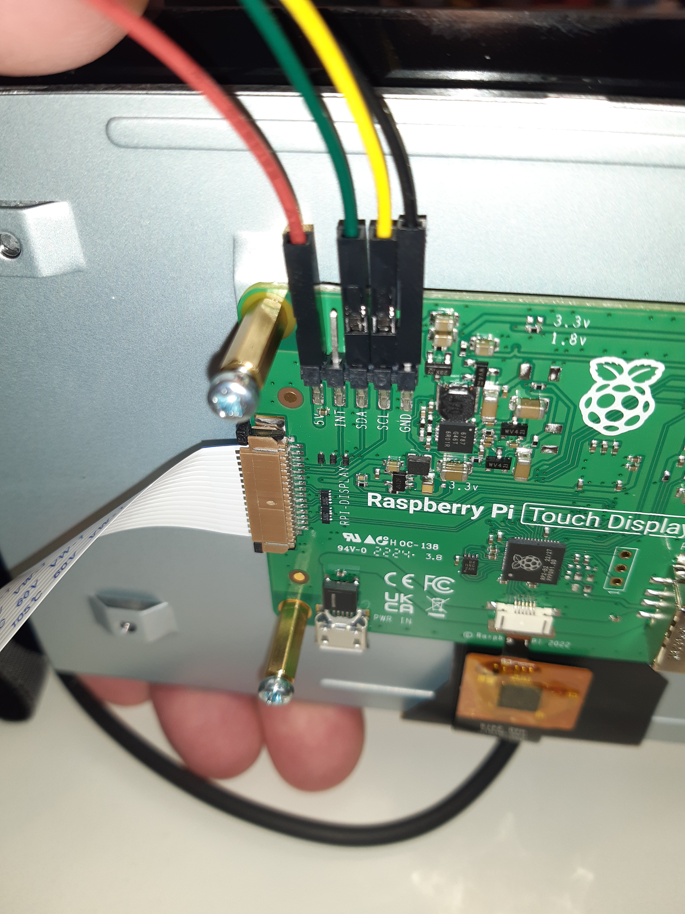
3D-Druck/Bildschirm hinten.jpg
