LangFlo00/Projekt-RETI-Ladesaeule/3D-Druck/Bildschirmhalter_hinten.jpg

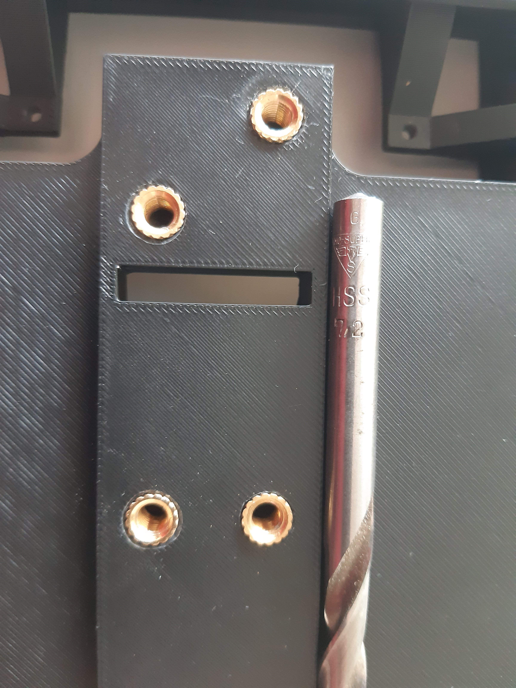
3D-Druck/Bildschirmhalter_hinten.jpg
